Feruzia/STAS-RG-Aqua-Culture/README.md

# STAS-RG-Aqua-Culture
The home base for STAS-RG Aqua Culture research. Covering everything from PCBs and ESP32 code to machine learning.
