Feruzia/STAS-RG-Aqua-Culture/hardware/PCB/05_Toksisitas_v2.4 (fixed, cetak)/05_Toksisitas_v2.4 (fixed, cetak).kicad_pcb

## KiCad design hardware/PCB/05_Toksisitas_v2.4 (fixed, cetak)/05_Toksisitas_v2.4 (fixed, cetak).kicad_pcb (2026-06-30)

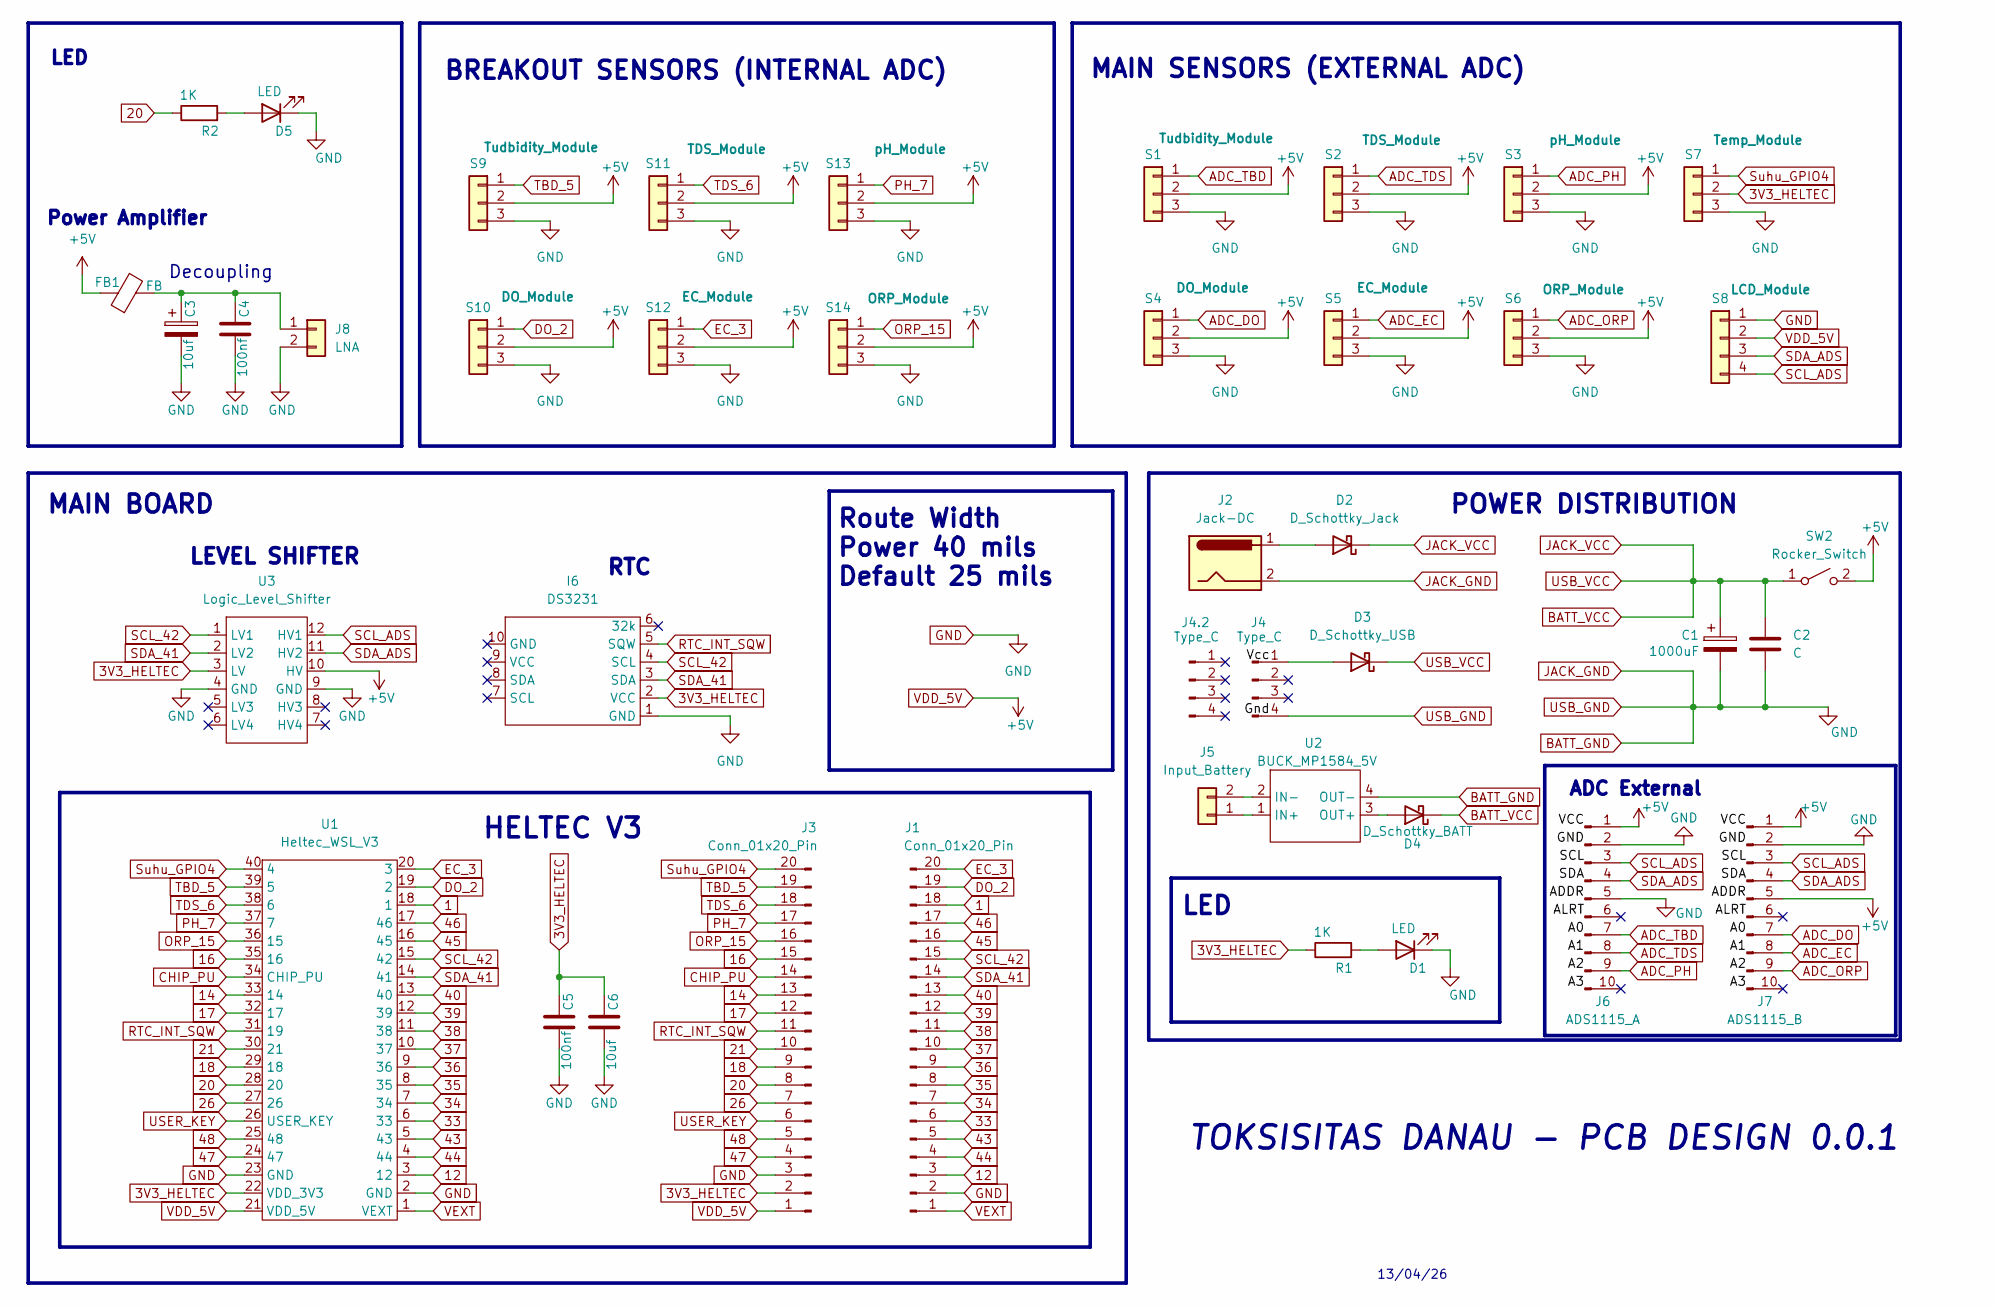
[picture p1: schematic 05_Toksisitas_v2.4 (fixed, cetak).kicad_sch]

Parts:
C1: 1000uF; CP_Radial_D10.0mm_P5.00mm
C2: C; C_Disc_D5.0mm_W2.5mm_P2.50mm
C3: 10uf; CP_Radial_D5.0mm_P2.00mm
C4, C5: 100nf; C_Disc_D5.0mm_W2.5mm_P2.50mm
C6: 10uf; C_Disc_D5.0mm_W2.5mm_P2.50mm
D1, D5: LED; LED_D5.0mm
D2: D_Schottky_Jack; D_DO-201AD_P15.24mm_Horizontal
D3: D_Schottky_USB; D_DO-201AD_P15.24mm_Horizontal
D4: D_Schottky_BATT; D_DO-201AD_P15.24mm_Horizontal
FB1: FB; R_Axial_DIN0207_L6.3mm_D2.5mm_P10.16mm_Horizontal
I6: DS3231 ; DS3231_Module
J1, J3: Conn_01x20_Pin; PinSocket_1x20_P2.54mm_Vertical
J2: Jack-DC; BarrelJack_Horizontal
J4: Type_C; Type_C_Conn
J4.2: Type_C; PinHeader_1x04_P2.54mm_Vertical
J5: Input_Battery; JST_XH_B2B-XH-A_1x02_P2.50mm_Vertical
J6: ADS1115_A; PinHeader_1x10_P2.54mm_Vertical
J7: ADS1115_B; PinHeader_1x10_P2.54mm_Vertical
J8: LNA; JST_XH_B2B-XH-A_1x02_P2.50mm_Vertical
R1, R2: 1K; R_Axial_DIN0207_L6.3mm_D2.5mm_P7.62mm_Horizontal
S1, S9: Tudbidity_Module; JST_PH_B3B-PH-K_1x03_P2.00mm_Vertical
S2, S11: TDS_Module; JST_PH_B3B-PH-K_1x03_P2.00mm_Vertical
S3, S13: pH_Module; JST_PH_B3B-PH-K_1x03_P2.00mm_Vertical
S4, S10: DO_Module; JST_PH_B3B-PH-K_1x03_P2.00mm_Vertical
S5, S12: EC_Module; JST_PH_B3B-PH-K_1x03_P2.00mm_Vertical
S6, S14: ORP_Module; JST_PH_B3B-PH-K_1x03_P2.00mm_Vertical
S7: Temp_Module; JST_PH_B3B-PH-K_1x03_P2.00mm_Vertical
S8: LCD_Module; JST_XH_B4B-XH-A_1x04_P2.50mm_Vertical
SW2: Rocker_Switch
U1: Heltec_WSL_V3; Heltec_WSL_V3_Module
U2: BUCK_MP1584_5V; BUCK_MP1584_5V_Module
U3: Logic_Level_Shifter; Level_Shifter_Module

Connections:
1: J1.18, U1.18 (1)
3V3_HELTEC: C5.1, C6.1, I6.2 (VCC), J3.2, R1.1, S7.2, U1.22 (VDD_3V3), U3.3 (LV)
12: J1.3, U1.3 (12)
14: J3.13, U1.33 (14)
16: J3.15, U1.35 (16)
17: J3.12, U1.32 (17)
18: J3.9, U1.29 (18)
20: J3.8, R2.1, U1.28 (20)
21: J3.10, U1.30 (21)
26: J3.7, U1.27 (26)
33: J1.6, U1.6 (33)
34: J1.7, U1.7 (34)
35: J1.8, U1.8 (35)
36: J1.9, U1.9 (36)
37: J1.10, U1.10 (37)
38: J1.11, U1.11 (38)
39: J1.12, U1.12 (39)
40: J1.13, U1.13 (40)
43: J1.5, U1.5 (43)
44: J1.4, U1.4 (44)
45: J1.16, U1.16 (45)
46: J1.17, U1.17 (46)
47: J3.4, U1.24 (47)
48: J3.5, U1.25 (48)
ADC_DO: J7.7, S4.1
ADC_EC: J7.8, S5.1
ADC_ORP: J7.9, S6.1
ADC_PH: J6.9, S3.1
ADC_TBD: J6.7, S1.1
ADC_TDS: J6.8, S2.1
BATT_GND: C1.2, C2.2, C3.2, C4.2, C5.2, C6.2, D1.1 (K), D5.1 (K), I6.1 (GND), J1.2, J2.2, J3.3, J4.4, J6.2, J6.5, J7.2, J8.2, S1.3, S2.3, S3.3, S4.3, S5.3, S6.3, S7.3, S8.1, S9.3, S10.3, S11.3, S12.3, S13.3, S14.3, U1.2 (GND), U1.23 (GND), U2.4 (OUT-), U3.4 (GND), U3.9 (GND)
BATT_VCC: C1.1, C2.1, D2.1 (K), D3.1 (K), D4.1 (K), SW2.1 (A)
CHIP_PU: J3.14, U1.34 (CHIP_PU)
DO_2: J1.19, S10.1, U1.19 (2)
EC_3: J1.20, S12.1, U1.20 (3)
unnamed: D1.2 (A), R1.2
unnamed: D2.2 (A), J2.1
unnamed: D3.2 (A), J4.1
unnamed: D4.2 (A), U2.3 (OUT+)
unnamed: D5.2 (A), R2.2
unnamed: J5.1, U2.1 (IN+)
unnamed: J5.2, U2.2 (IN-)
unnamed: C3.1, C4.1, FB1.2, J8.1
ORP_15: J3.16, S14.1, U1.36 (15)
PH_7: J3.17, S13.1, U1.37 (7)
RTC_INT_SQW: I6.5 (SQW), J3.11, U1.31 (19)
SCL_42: I6.4 (SCL), J1.15, U1.15 (42), U3.1 (LV1)
SCL_ADS: J6.3, J7.3, S8.4, U3.12 (HV1)
SDA_41: I6.3 (SDA), J1.14, U1.14 (41), U3.2 (LV2)
SDA_ADS: J6.4, J7.4, S8.3, U3.11 (HV2)
Suhu_GPIO4: J3.20, S7.1, U1.40 (4)
TBD_5: J3.19, S9.1, U1.39 (5)
TDS_6: J3.18, S11.1, U1.38 (6)
USER_KEY: J3.6, U1.26 (USER_KEY)
VDD_5V: FB1.1, J3.1, J6.1, J7.1, J7.5, S1.2, S2.2, S3.2, S4.2, S5.2, S6.2, S8.2, S9.2, S10.2, S11.2, S12.2, S13.2, S14.2, SW2.2 (B), U1.21 (VDD_5V), U3.10 (HV)
VEXT: J1.1, U1.1 (VEXT)

Notes on the sheet:
13/04/26
LEVEL SHIFTER
ADC External
Decoupling
TOKSISITAS DANAU - PCB DESIGN 0.0.1
LED
Power Amplifier
BREAKOUT SENSORS (INTERNAL ADC)
POWER DISTRIBUTION
Route Width Power 40 mils Default 25 mils
MAIN SENSORS (EXTERNAL ADC)
MAIN BOARD
HELTEC V3
RTC

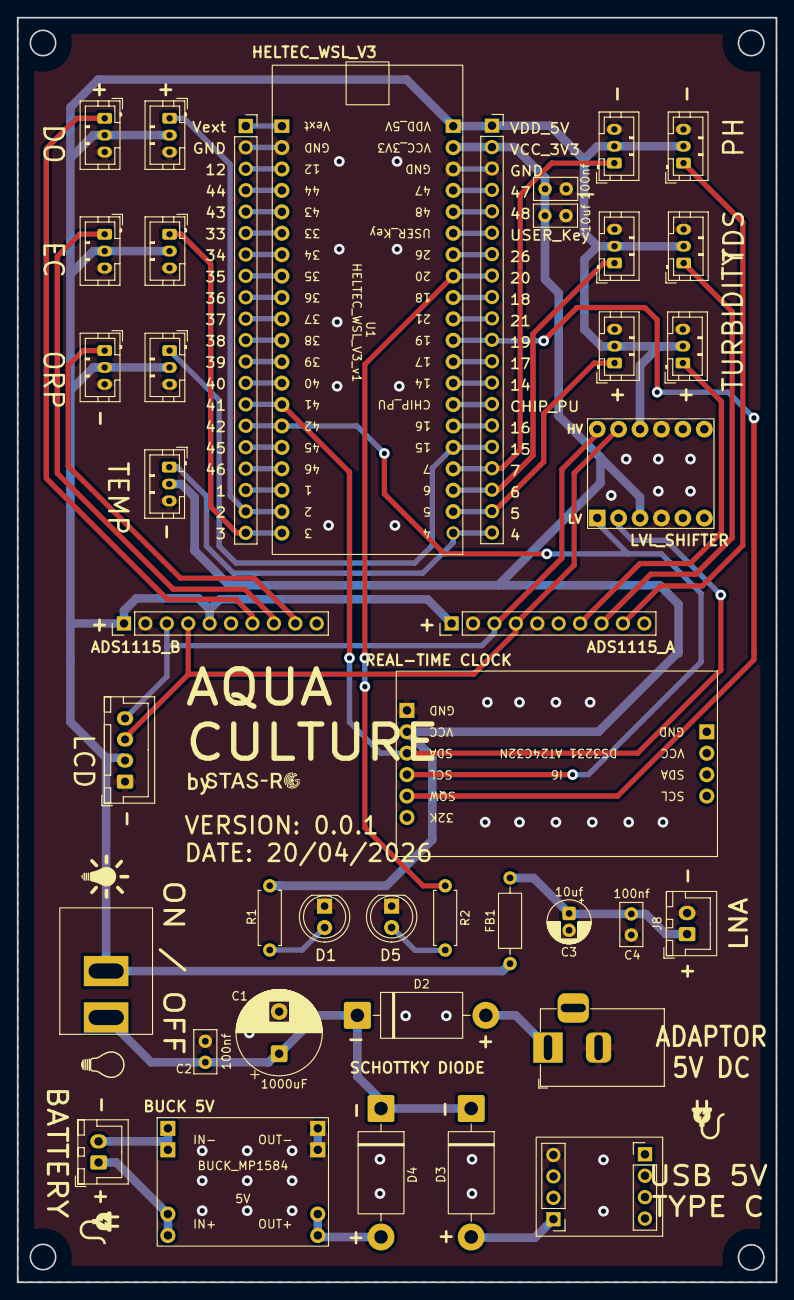
[picture p2: board 05_Toksisitas_v2.4 (fixed, cetak).kicad_pcb from above]

Board: 2 copper layers, 90.0 x 150.0 mm, 42 parts (0 on the bottom side), 56 nets.
