Feruzia/STAS-RG-Aqua-Culture/(commit log)

2026-05-07 Tambah file kalibrasi sensor
2026-05-07 Enhance README with sensor details and calibration steps
    Added detailed sensor descriptions and calibration procedures for various water quality sensors used in research.
2026-06-30 Lastest PCB
    [05_Toksisitas_v2.4 (fixed, cetak)-B_Cu.gbl, 05_Toksisitas_v2.4 (fixed, cetak)-B_Mask.gbs, 05_Toksisitas_v2.4 (fixed, cetak)-B_Silkscreen.gbo, 05_Toksisitas_v2.4 (fixed, cetak)-Edge_Cuts.gm1, 05_Toksisitas_v2.4 (fixed, cetak)-F_Cu.gtl, 05_Toksisitas_v2.4 (fixed, cetak)-F_Mask.gts, 05_Toksisitas_v2.4 (fixed, cetak)-F_Silkscreen.gto, 05_Toksisitas_v2.4 (fixed, cetak)-job.gbrjob]
2026-06-30 Create kalibrasi sensor
